DTABH/Flora-ESP8266/Images/IMG_1237.jpg

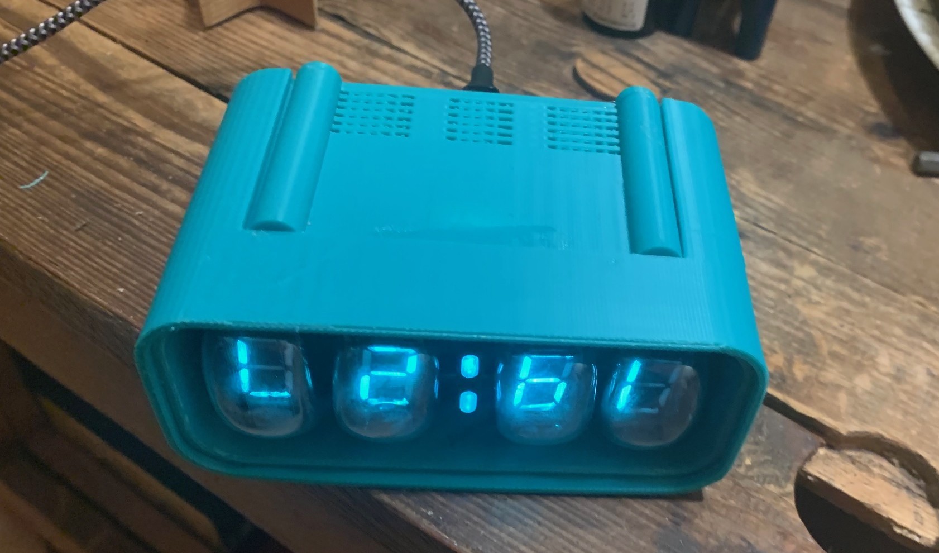
Images/IMG_1237.jpg
