DTABH/Flora-ESP8266/Firmware/FLORA_FIRMWARE/fns.ino

String macToStr(const uint8_t* mac) {
  String result;
  for (int i = 0; i < 6; ++i) {
    if (mac[i] < 0x10) result += "0";
    result += String(mac[i], HEX);
    if (i < 5)
      result += ':';
  }
  result.toUpperCase();
  return result;
}

String macLastThreeSegments(const uint8_t* mac) {
  String result;
  for (int i = 3; i < 6; ++i) {
    if (mac[i] < 0x10) result += "0";
    result += String(mac[i], HEX);
  }
  result.toUpperCase();
  return result;
}

bool readConfig() {
  File stateFile = SPIFFS.open("/config.json", "r");
  if (!stateFile) {
    Serial.println("[CONF] Failed to read config file... first run?");
    Serial.println("[CONF] Creating new file...");
    saveConfig();
    return false;
  }
  DeserializationError error = deserializeJson(json, stateFile.readString());
  stateFile.close();
  return true;
}

bool saveConfig() {
  File configFile = SPIFFS.open("/config.json", "w");
  if (!configFile) {
    Serial.println("[CONF] Failed to open config file for writing");
    return false;
  }
  serializeJson(json, configFile);
  //serializeJson(json, Serial);
  configFile.close();
  return true;
}

bool deleteConfig() {
  File configFile = SPIFFS.open("/config.json", "r");  
  if (configFile) {
    configFile.close();
    if ( SPIFFS.remove("/config.json"))
    {
      Serial.println("OK Config Deleted");
      return true;
    }
    else
    {
      Serial.println("Error Config Deleted");
      return false;
    }
  }
  else
  {
    Serial.println("OK Config not exists.");
  }
  return true;
}
