DTABH/Flora-ESP8266/(commit log)

2025-12-14 Add files via upload
    Replaced ICACHE_RAM_ATTR with IRAM_ATTR due to crashes
    Implemented a RTC-Clock and 3 Buttons so that the clock works without WLAN connection or NTP-Server
    With the 3 Buttons time and date can/must be set if no NTP can connected. Implemented therefor displaying month an year
    RTC-only mand mixed mode can be configred by pressing button combination
    [FLORA_FIRMWARE.ino, NDP_fns.ino, VFD_fns.ino, menue.ino, neopixel_fns.ino]
2025-12-14 Add files via upload
    Hardware implementation of a small china RTC modul on the backside of the pcb
2025-12-15 Add files via upload
    Changes:
    Version -> #define FW_VERSION "6.0.1 dtabh"
    Lowest Brightness is now 2 and steps also 2 ( Clock in the night should be very very dark)
    Configuration of medium brightness possible with configuration on webpage
    showing day and month every 30 or 60 seconds with configuration on webpage
    Extended menu for Nightmode with begin hour 19,20,21,22 with configuration on webpage
    Toggle to switch on/off Nightmode with automatic reset of toggle to normal at 6'clock
    Possible bug : opening Webpage after reprogramming leads to restart of the clock, until FireFox browser cache is flashed
    After flashing the browser cache everythings ok.
    [FLORA_FIRMWARE.ino, VFD_fns.ino, menue.ino, neopixel_fns.ino]
2025-12-16 Add files via upload
    Bugfix Toggle Night Mode.
    Red Colons during menu input.
    [FLORA_FIRMWARE.ino, VFD_fns.ino, menue.ino]
2025-12-17 Add files via upload
    Nightmode changed in start hour of night mode
    and implemented ending hour Only works corretc in 24 h mode
    Bugfix crash of webpage
    [FLORA_FIRMWARE.ino, NDP_setup.ino, VFD_fns.ino, fns.ino, menue.ino]
